adwait13/wall_follower_robot/ME2400 Project Report.pdf

## INDIAN INSTITUTE OF TECHNOLOGY MADRAS

DEPARTMENT OF MECHANICAL ENGINEERING

## AUTONOMOUS WALL-FOLLOWING ROBOT

ME2400 Project Report

## GROUP 10

ME23B123 | Adwait
ME23B101 | Sumanth
ME23B104 | Daniel
ME23B155 | Amruta
ME23B117 | Thomas

May 2025

## What lies ahead?

Group 10

May 4, 2025

## Contents

Aim and Objectives | 3
Chassis Design and Component Placement | 3
Controller Design and Tuning | 6
Simulink Model | 18
Performance Analysis | 18
Team Member Contributions | 19
Budget | 20
Gallery | 20
Conclusion | 20

2

## Aim and Objectives

Aim

To design and develop an autonomous robot capable of moving a wheelchair to the back of a car model by maintaining a gap of more than 1 cm from the car’s right side, executing a left turn upon reaching the rear end, and stopping after moving a fixed distance parallel to the trunk, using simple sensors and microcontroller-based control without machine vision.

Objectives

- Build a three-wheeled or more robot that fits within a 10 cm × 10 cm × 10 cm volume to operate within the given constraints.
- Employ ultrasonic or other suitable sensors with an Arduino or ESP32 microcontroller to detect the car’s side and rear end.
- Implement a control algorithm (here- PID control) to maintain a consistent gap (>1 cm) from the car’s right side during navigation.
- Program the robot to detect the end of the car and perform a left turn autonomously.
- Ensure the robot stops at a fixed position near the center of the car’s rear.
- Adhere to safety considerations to prevent injury during operation.
- Complete the project within a budget of Rs. 4500, including all components and materials.

## Chassis Design and Component Placement

Component List and Justifications

Component | Specification | Justification
Arduino UNO | 16 MHz, 32KB flash | Sufficient I/O pins and processing power for sensor integration and motor control
L298N Motor Driver | Dual H-bridge, 2A max | Supports two DC motors with PWM speed control and direction control
DC Geared Motors (2) | 6V, 200 RPM | Provides balanced speed and torque for stable wall-following

3

Component | Specification | Justification
HC-SR04 Ultrasonic Sensor | Range: 2-400 cm | Accurate distance measurement for wall-following within required range
Batteries | 3xLi ion (3.7V) | Sufficient power for motors and electronics while maintaining portability
Motor Mounts and Wheels | Custom- designed | Optimized for stability and maneuverability

Other items used: Electrical Tape, Jumper wires, Double sided tape, USB cable, Wire stripper cutter, Multimeter, body – designed and fabricated out of wood.

Design Considerations

The chassis was designed to balance several key requirements:

- Sensor positioning: The ultrasonic sensor is mounted perpendicular to the direction of travel for accurate wall distance measurement
- We created our chassis using the Fusion360 program, keeping in mind the design specifications. We decided to use wood for our chassis because the model needed to be both easy to manufacture and durable and firm. We carpentered the wood outside Taramani and used glue to put the pieces together.
- Compactness: Overall dimensions were tried to be kept minimal (10 cm × 10cm× 10 cm) to allow for the given dimensions.
- Battery pack needed to have a separate compartment given it occupies a lot of space, and needs constant changing of batteries during testing

4

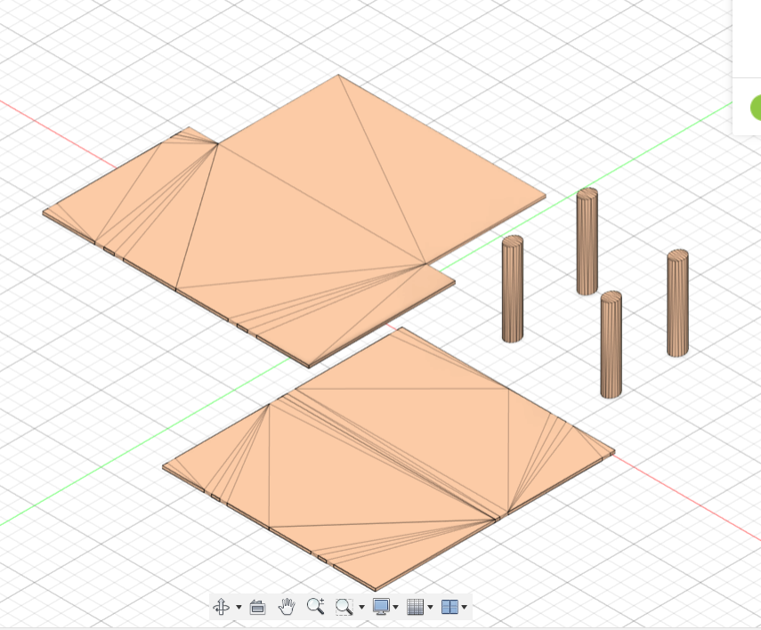
[picture p1: figure]

[Figure 1: Chassis design schematic showing component placement]

5

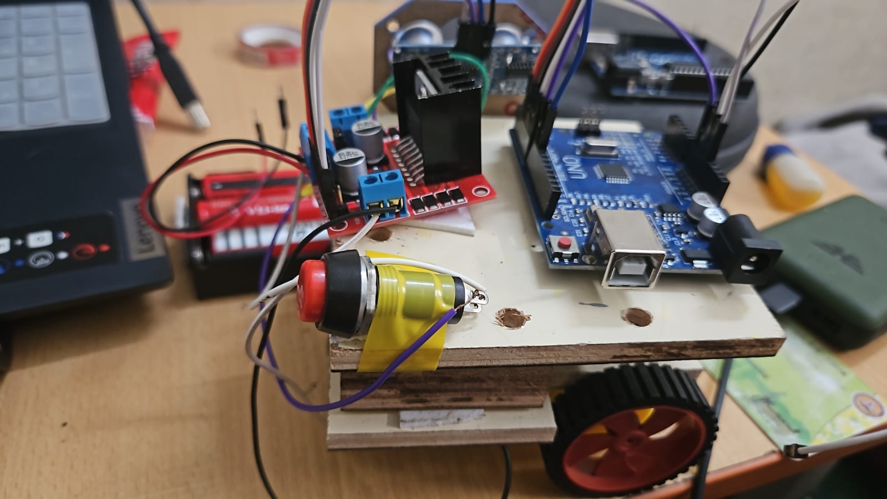
[picture p2: figure]

[Figure 2: Robot design]

## Controller Design and Tuning

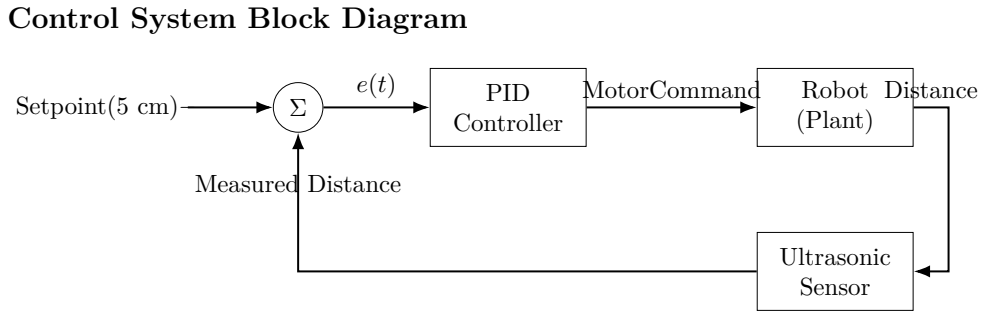
[picture p3: figure]
Control System Block Diagram; Setpoint(5 cm); PID Controller; Robot (Plant); Ultrasonic Sensor; MotorCommand; Distance; Measured

Figure 1: Control system block diagram for wall-following robot with sensor in the feedback loop.

6

Transfer Function Model

## Control System Dynamics

Sensor Input:

The distance to the wall d(t) is measured via an ultrasonic sensor.

Setpoint:

The desired distance from the wall is a fixed value:

dset = 5 cm

Error Computation:

The error e(t) at time t is computed as:

e(t) = d(t) − dset = d(t) − 5

PID Controller:

The control output u(t) generated by the PID controller is given by:

u(t) = Kp · e(t) + Ki

·

Z
e(t) dt + Kd ·

de(t)
dt

This output u(t) adjusts the motor speeds and, consequently, the turning angle of the robot.

Actuator Behavior:

The motor speeds are adjusted as follows:

Right motor speed: baseSpeed − u(t)

Left motor speed: baseSpeed + u(t)

The difference in speeds creates an angular velocity ω(t), causing the robot to steer.

Modeling the Dynamics:

Let’s define the following variables: - d(t): Distance to the wall - θ(t): Robot’s angle to the wall (ideal = 0) - v: Constant forward velocity - ω(t): Angular velocity (function of the difference in wheel speeds and PID output)

7

Lateral Dynamics

From the robot’s kinematics (unicycle model), we have the following equations:

For the change in distance d(t):

dd(t)
dt = v · sin(θ(t)) ≈ v · θ(t) (for small θ(t))

For the change in angle θ(t):

dθ(t)
dt = ω(t)

Now, using the PID controller output ω(t), we have:

ω(t) ∝ u(t) = PID(e(t)) = Kp · e(t) + Ki

·

Z
e(t) dt + Kd ·

de(t)
dt

Substituting e(t) = d(t) − 5, we get:

ω(t) = Kp · (d − 5) + Ki

·

Z
(d − 5) dt + Kd ·

d(d − 5)
dt

This can be written as:

ω(t) = Kp · d + Ki

·

Z

dd(t)
dt dt + Kd ·

d

2d(t)
dt²

+ (constants)

Differentiating the Lateral Dynamics:

Next, we differentiate the equation for d(t):

d

2d(t)
dt²

= v ·

dθ(t)
dt = v · ω(t)

Substituting ω(t) from above, we get:

d

2d(t)
dt²

= v ·

Kp · d + Ki

·

Z

dd(t)
dt dt + Kd ·

d

2d(t)
dt²

Rearranging Terms:

Moving all terms to one side:

d

2d(t)
dt²

− v · Kd ·

dd(t)
dt − v · Kp · d = v · Ki

·

Z

dd(t)
dt dt

This simplifies to:

d

2d(t)
dt²

+ a1 ·

dd(t)
dt + a0 · d(t) = a0 · dset

where:
a1 = −v · Kd, a0 = −v · Kp

8

Final Governing Equation (Second-Order Approximation):

The final second-order approximation is:

d

2d(t)
dt²

+ a1 ·

dd(t)
dt + a0 · d(t) = a0 · dset

Why Not a First-Order System?

A first-order system would only capture position or angle without any dynamics of rate-of-change. Since the PID control involves derivatives and integrals, the system exhibits second- or third-order behavior. The robot’s steering response depends on angular acceleration, which results from wheel speed differences, leading to at least second-order dynamics.

## Robot Dynamics

Robot’s Kinematics:

The robot’s orientation θ(t) changes based on its angular velocity ω(t):

dθ(t)
dt = ω(t)

Lateral Dynamics and Rotation:

The robot’s distance to the wall d(t) is affected by both its linear and angular velocities. The lateral velocity (perpendicular to the wall) is proportional to the robot’s forward speed and its angle to the wall:

dd(t)
dt = v · sin(θ(t)) ≈ v · θ(t) (for small θ(t))

The change in the angle θ(t) over time is given by:

dθ(t)
dt = ω(t)

Turning and Lateral Dynamics Combined:

The turning behavior is modeled by considering both the angular velocity ω(t) and the lateral dynamics of the robot. The second-order governing equation for d(t) and θ(t) can be written as a set of coupled differential equations:

For the position (distance to the wall):

d

2d(t)
dt²

+ a1 ·

dd(t)
dt + a0 · d(t) = a0 · dset

For the orientation (angle to the wall):

dθ(t)
dt = ω(t) = v
L
- u(t)

9

## Final Governing Equations (Lateral + Rotation)

### 1. Lateral Dynamics (Position to the Wall d(t)):

d

2d(t)
dt²

+ a1 ·

dd(t)
dt + a0 · d(t) = a0 · dset

where: - d(t): Distance to the wall - dset: Desired set distance to the wall - a1 and a0: Constants depending on the robot’s dynamics and PID control gains

### 2. Rotation Dynamics (Orientation θ(t)):

dθ(t)
dt = ω(t) = v
L
- u(t)

where: - θ(t): Robot’s angle relative to its initial orientation - v: Robot’s forward speed - L: Track width (distance between wheels) - u(t): Output of the PID controller

Thus, the final governing equations are:

d

2d(t)
dt²

+ a1 ·

dd(t)
dt + a0 · d(t) = a0 · dset

dθ(t)
dt =

v
L
- u(t)

### 5. PID Controller Output:

The PID controller output is given by:

u(t) = Kp · e(t) + Ki

·

Z
e(t) dt + Kd ·

de(t)
dt

where: - e(t) is the distance error, e(t) = dset − d(t), - Kp, Ki
, and Kd are the
proportional, integral, and derivative gains of the PID controller.

PID Implementation

The PID control law in the time domain is:

u(t) = Kpe(t) + Ki

Z t

0

e(τ )dτ + Kd

de(t)
dt

In the Laplace domain, the PID controller transfer function is:

C(s) = Kp +

Ki
s

+ Kds

Using the tuned parameters:

Kp = 6.0, | Ki = 0.007, | Kd = 13.9
| 10

## Closed-Loop Transfer Function

The closed-loop transfer function combining the plant and controller is:

T(s) = C(s)G(s) 1 + C(s)G(s)

where G(s) is the transfer function of the open-loop control system (forward path).

Tuning Methodology

### 4.3.1 PID Control Implementation

The PID controller was implemented with the following structure:

cpp

error = distance - fixedDistance; // Error calculation

P = error; // Proportional term

I += error; // Integral term

I = constrain(I, -400, 400); // Anti-windup protection

D = error - prevError; // Derivative term

errorCorrection = (Kp*P) + (Ki*I) + (Kd*D);

prevError = error;

rightSpeed = baseSpeed - errorCorrection;

leftSpeed = baseSpeed + errorCorrection;

### 4.3.2 Tuning Methodology

Control System Implementation and Tuning Initially, we tried to find Kp,Ki, Kd using the Ziegler Nichols method, and tried to find the neutral stability point by manually changing Kp and setting Ki and Kd to zero. We tried to find the Kp value for which the bot is oscillating and find the time period. But these attempts to find Kp, KI and KD values suffered from instability, which we believe is due to integral action amplifying sensor noise and accumulating error rapidly. This prompted a shift to manual PID control, and the values of Kp, Kd and Ki were determined experimentally through trial and error. Fine tuning was performed based on observation of the response. Proportional gain (Kp) was reduced from an initial value of 10 to 6 through iterative testing, which minimized oscillations at the cost of slightly increased settling time . Derivative gain (Kd) was raised to 13.9 to dampen overshoot and improve response to sudden distance changes. Sensor noise, exacerbated by motor-induced vibrations in the lightweight chassis, was mitigated using a 5-sample moving average filter on ultrasonic data, reducing fluctuations.

| 11

The controller was tuned using a combination of methods:

1. Initial Parameter Estimation:
- Started with conservative values (Kp = 1.0, Ki = 0, Kd = 0)
- Observed system response and stability
2. Manual Fine-Tuning:
- Gradually increased Kp until acceptable response time
- Added derivative control (Kd) to reduce overshoot
- Added minimal integral control (Ki) to eliminate steady-state error
3. Final Parameter Optimization:
After numerous test iterations, the final tuned values were:
- Kp = 6.0
- Ki = 0.007
- Kd = 13.9
- Correction factor for motor imbalance = 0.695

### 4.3.3 Noise Reduction Techniques

Several techniques were implemented to reduce noise in sensor readings:

1. Moving Average Filter: 5-sample averaging to smooth ultrasonic measurements

cpp

float readAverageDistance() {

float sum = 0;

for (int i = 0; i < 5; i++) {

measureDistance();

sum += distance;

delay(10);

}

return sum / 5.0;

}

2.

12

End-of-Wall Detection Validation:

cpp

if(distance < 20) {

wallFollow();

} else {

stopMotors(100);

turnRight();

goStraight();

}

### 4.3.4 Full Arduino Program

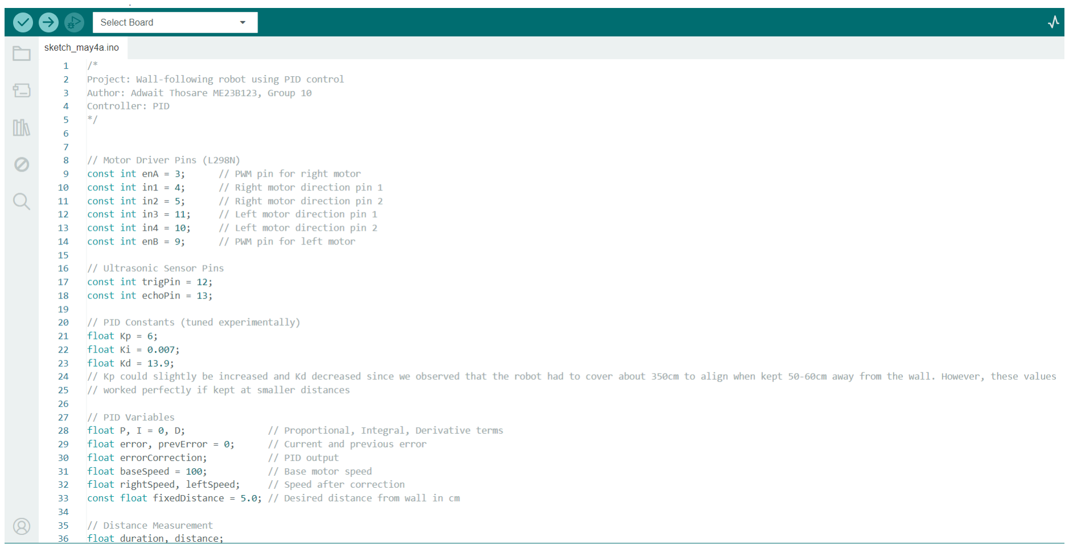
[picture p4: figure]

13

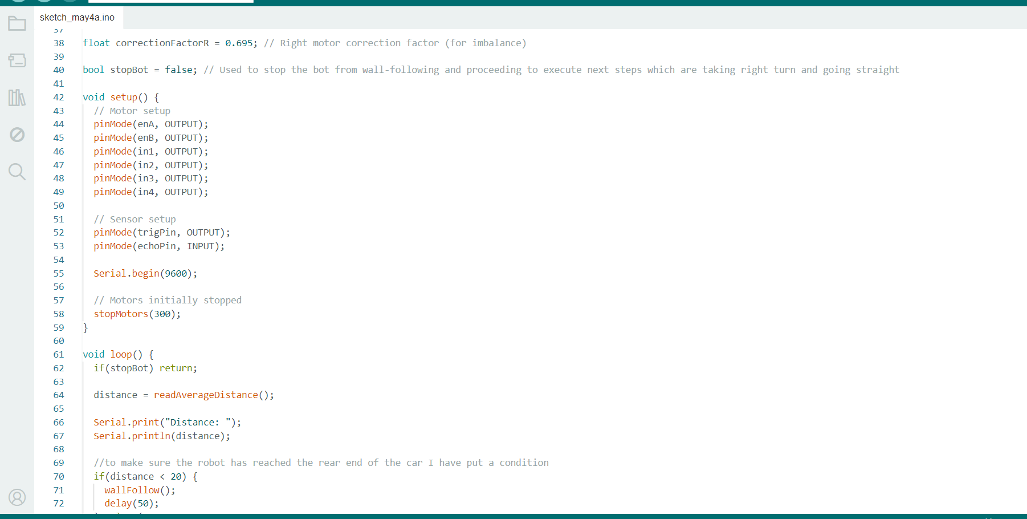
[picture p5: figure]

14

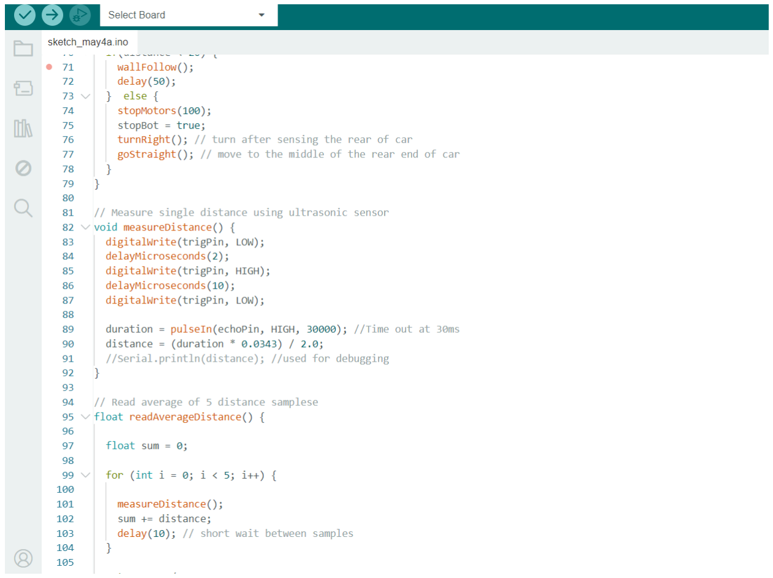
[picture p6: figure]

15

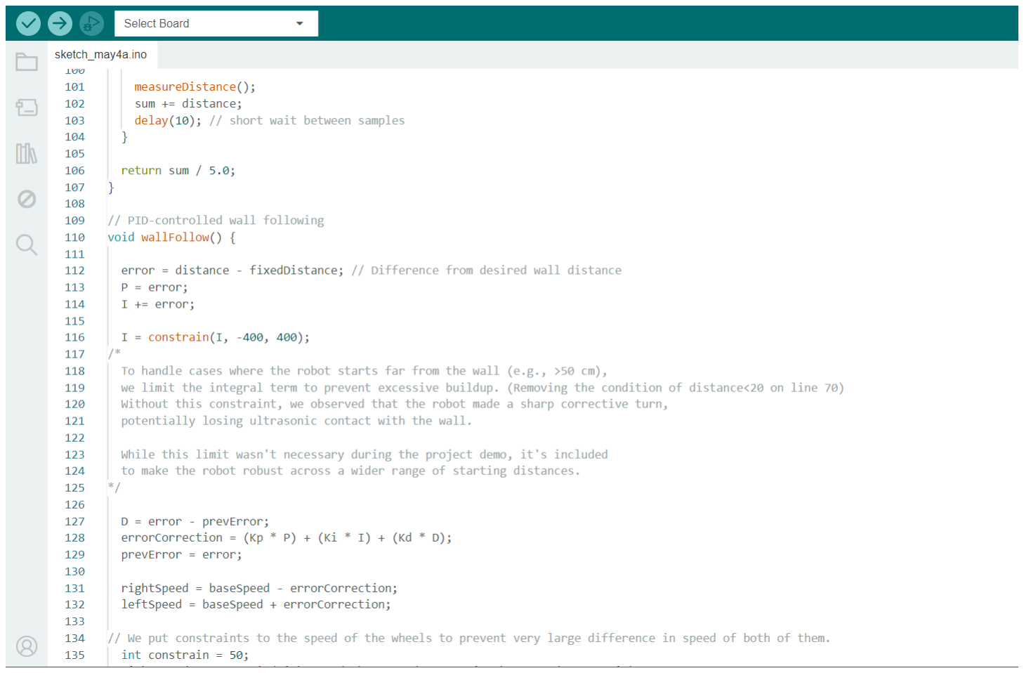
[picture p7: figure]

16

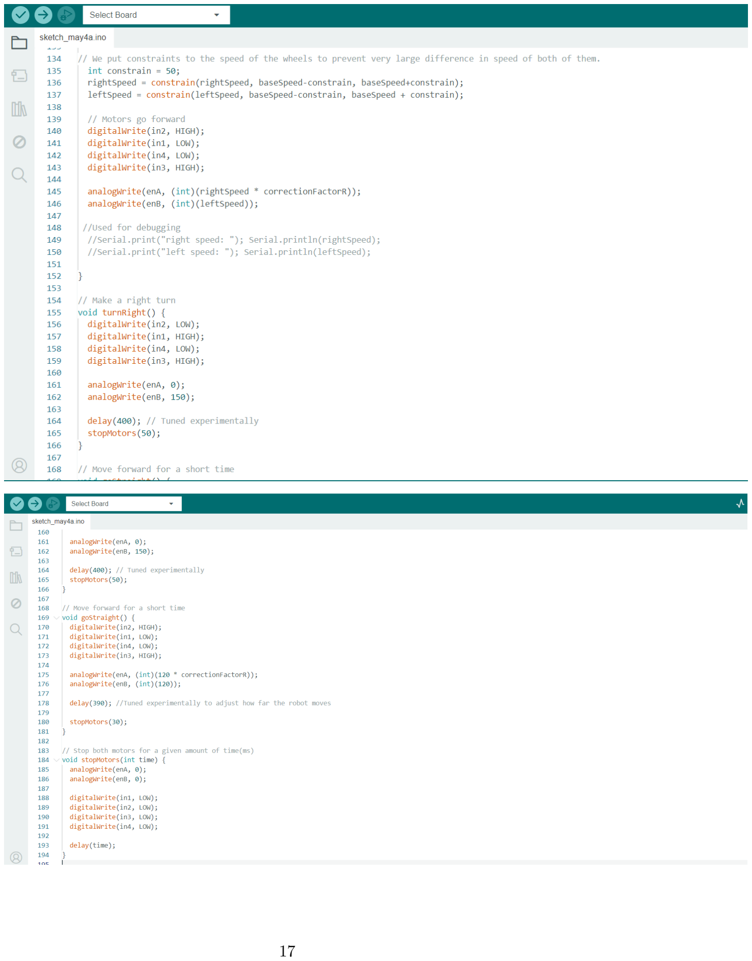
[picture p8: page 17]

17

## Simulink Model

A Simulink model was developed to validate the controller design before implementation. The model included:

1. PID Controller Block:
- Proportional (Kp = 6.0)
- Integral (Ki = 0.007) with anti-windup protection
- Derivative (Kd = 13.9) with low-pass filtering for noise reduction
2. Plant Model:
- Second-order transfer function as derived above
- Motor saturation (PWM limits 50-230)
- Motion dynamics with differential drive
3. Sensor Model:
- Simulated HC-SR04 with 50 ms update rate
- 5-sample moving average filter
- Random noise and measurement delays

## Performance Analysis

### 6. Challenges and Solutions

Challenge | Solution Implemented | Outcome
Ultrasonic sensor noise | 5-sample moving average filter | Reduced noise
Motor imbalance | Applied correction factor
(0.69) to right motor
| | Balanced straight-line motion
Integral windup | Implemented constraint on I term | Eliminated oscillations
Variable battery voltage | Lowered base speed (100 PWM) | Consistent performance across battery life
False end detection | Added distance threshold (20 cm) | Eliminated false positives

18

## Team Member Contributions

Each team member contributed significantly to the project:

- ME23B123 Adwait
Adwait was our chief code wrangler and PID whisperer. He handled most of the algorithm development, parameter tuning, and code optimization. If something worked, it was probably because Adwait fixed it. He also led the testing and performance evaluation, and was usually the first to spot (and sometimes create) a bug. In addition to his software role, he also pitched in during manufacturing where needed — notably fabricating a custom height extension for the caster wheel — to help ensure the robot came together smoothly.
- ME23B101 Sumanth
Sumanth took charge of the report and the chassis, from design to manufacturing, and made sure all the hardware actually fit together. He picked out the components, did the heavy lifting on assembly, and was always up for another round of wiring and testing. His patience during the tuning phase and consistent support made a big difference in getting the robot to perform reliably. If you see a straight line on the robot, Sumanth probably measured it twice.
- ME23B104 Daniel
Daniel helped us in testing protocols and performance checks. Daniel mainly assisted during basic testing phases. His calm presence was helpful during evaluations, and he was around to support the process when needed.
- ME23B155 Amruta
Amruta contributed to some parts of the code. Her involvement added value in keeping things on track as deadlines approached, and also pitched in with whatever was needed.
- ME23B117 Thomas
Thomas was our logistics expert, always ready to hunt down missing components or tools. Thomas helped out by sourcing a few components early in the project. He pitched in when possible, especially in the early logistics.

19

## Budget

Component | Amount ()
Chassis kit L298N Battery Pack (4. AA) Battery Pack (3): Li-Ion (3.7V) Battery holders (3) Insulation tape Double sided tape Breadboard Battery charger Chassis carpentry | 650 200 120 450 200 15 15 70 140 250
Total | 2110

Note: Our total doesn’t include the cost of two Arduinos and two motor drivers that we accidentally fried during testing, and borrowed from friends, hehe :)

## Gallery

Gallery:

DRIVE CONTAINING TESTING VIDEOS AND IMAGES! (https://drive.google.com/drive/folders/1NlnXi7AlrmuTHrnU8MlFFopzxugvIv6G?usp=sharing)

## Conclusion

Designing and implementing an autonomous wall-following robot with PID control proved to be a challenging yet rewarding engineering endeavor, blending theoretical control principles with practical hardware integration.

- Key Achievements:

– Successfully implemented a PID control system with tuned parameters (Kp = 5.9, Ki = 0.06, Kd = 14.97) to maintain a stable 5 cm gap from walls.

– Addressed integral-induced instability through anti-windup clamping (I = constrain(I, −100, 100)), enabling stable operation despite sensor noise.

– Engineered a compact chassis with optimized sensor placement and motor coordination for reliable navigation.

- Skills Developed:

– PID tuning via empirical methods (Ziegler-Nichols initialization was tried, but later resorted to manual tuning followed by iterative refinement).

20

– Sensor fusion and noise mitigation using 5-sample moving average filtering.

– Hardware-software co-design, including motor driver calibration and power management. We learnt and improved on our:

– 1. Programming Skills

Arduino C/C++ coding Structuring modular code (functions for measurement, control, motion) Using serial communication for debugging and visualization

2. PID Tuning

Practical experience in adjusting Kp, Ki, Kd for optimal performance Understanding the effect of each term

3. Electronics Hardware

Wiring and interfacing ultrasonic sensors, L298N motor drivers, and DC motors Understanding the role of each pin and component

4. Motor Control

* Controlling motor direction and speed via PWM * Learning the relationship between duty cycle and speed

5. Mechanical Design Insight

Effect of chassis alignment, wheelbase, and center of gravity on motion Importance of symmetry and calibration

- Lessons Learned:
1. Integral Action Nuances: While Ki
improved steady-state accuracy, unconstrained integration caused instability, necessitating anti-windup protection.
2. Control Systems in Practice: How PID controllers work in real-world scenarios (not just theory). Understanding tuning challenges (e.g., overshoot, steady-state error, integral windup).
3. Sensor Integration: Learned how ultrasonic sensors work and their limitations (e.g., noise, cone angle). Importance of averaging and filtering sensor data.
4. Embedded Systems Behavior: Learned the role of real-time constraints, loop timing, and how delay() affects system performance. How PWM signals influence hardware (motor speed).
5. System Debugging: How to identify issues (e.g., sharp turns, sensor misreads). The importance of serial monitoring for real-time feedback.

21

- Challenges Overcome:
- Mitigating motor-induced vibrations that corrupted sensor readings.
- Ensuring robust end-of-structure detection and turning within spatial constraints.

This project highlighted the iterative nature of control system design, where theoretical models guided initial tuning, but real-world testing was indispensable for refinement. The final implementation demonstrated effective PID control under practical constraints, providing valuable insights into embedded robotics and adaptive control strategies.

Looking back, this project was truly a great learning curve for all of us. From debugging code at midnight to chasing down replacements for damaged components, every challenge taught us something new (even if it was just how not to fry an Arduino). We’d like to extend a special thanks to Manish sir for his guidance, encouragement, and-most importantly-the pizzas on demo day, which definitely boosted both our morale and productivity:-)

## References

1. Arduino. (2023). PID Library. https://playground.arduino.cc/Code/PIDLibrary/ (https://playground.arduino.cc/Code/PIDLibrary/)
2. HC-SR04 Ultrasonic Sensor Datasheet
3. L298N Dual H-Bridge Motor Driver Documentation
4. National Instruments. (2022). PID Theory Explained. http: //www.ni.com/white-paper/3782/en/

22
